sonderswag/Atmel-GPS-Sensor-Watch/TransReciver/RFM69-master/Examples/MotionMote/LasercutCase_R3.dxf

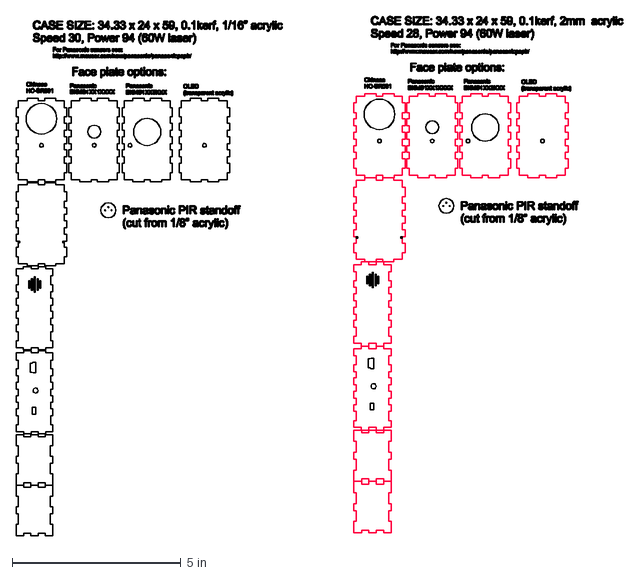
[picture p11: CAD file, 2017-03-10, last stored version]
TransReciver/RFM69-master/Examples/MotionMote/LasercutCase_R3.dxf
18.0 x 15.4 in
