sonderswag/Atmel-GPS-Sensor-Watch/TransReciver/RFM69-master/Examples/SonarMote/SonarMote_lasercut plans_1.75mm acrylic.dxf

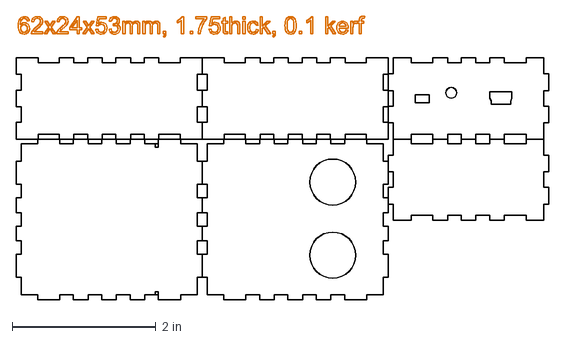
[picture p12: CAD file, 2017-03-10, last stored version]
TransReciver/RFM69-master/Examples/SonarMote/SonarMote_lasercut plans_1.75mm acrylic.dxf
7.41 x 3.94 in
