sonderswag/Atmel-GPS-Sensor-Watch/Digital_IO/DigitalIo.c

//
//  main.c
//  parse_gps
//
//  Created by Christian Wagner on 2/28/17.
//  Copyright © 2017 Christian Wagner. All rights reserved.
//

#include "DigitalIo.h"
// assumes ddr register is already enable for output and not input
void digitalWrite(char port, char state)
{
    pinMode(port, 1); //put to output
    if (port == 1 || (port >= 23 && port <= 28 )) // c
    {
        if (port == 1)
        {
            if (state == 1) PORTC |= (1<<6);

            else PORTC &= ~(1<<6);

        }
        else
        {
            port -= 23;
            if (state == 1) PORTC |= (1<<port);

            else PORTC &= ~(1<<port);

        }
    }
    else if ((port >= 2 && port <= 6) || ( port >= 11 && port <= 13)) // d
    {
        if (port >= 2 && port <= 6)  port -= 2;

        else  port -= 6;

        if (state == 1) PORTD |= (1<<port);

        else PORTD &= ~(1<<port);;

    }
    else if ((port >= 9 && port <= 10) || (port >= 14 && port <= 19)) //b
    {
        if (port >= 9 && port <= 10) port -= 3;

        else port -= 14;


        if (state == 1) PORTB |= (1<<port);

        else PORTB &= ~(1<<port);
    }
}

// changes the pinmode to either input or output
void pinMode(char port, char mode)
{
    if (port == 1 || (port >= 23 && port <= 28 )) // c
    {
        if (port == 1)
        {
            if (mode == 1) DDRC |= (1<<6);

            else DDRC &= ~(1<<6);

        }
        else
        {
            port -= 23;
            if (mode == 1) DDRC |= (1<<port);

            else DDRC &= ~(1<<port);

        }
    }
    else if ((port >= 2 && port <= 6) || ( port >= 11 && port <= 13)) // d
    {
        if (port >= 2 && port <= 6)  port -= 2;

        else  port -= 6;

        if (mode == 1) DDRD |= (1<<port);

        else DDRD &= ~(1<<port);;

    }
    else if ((port >= 9 && port <= 10) || (port >= 14 && port <= 19)) //b
    {
        if (port >= 9 && port <= 10) port -= 3;

        else port -= 14;


        if (mode == 1) DDRB |= (1<<port);

        else DDRB &= ~(1<<port);
    }
}

//reads the digital input to the given pin number
char digitalRead(char port)
{
    pinMode(port, 0); //set to input
        if (port == 1 || (port >= 23 && port <= 28 )) // c
    {
        if (port == 1)
        {
            if ((PINC & 1<<6) == 0)
                return 0;
            else
                return 1;
        }
        else
        {
            port -= 23;
            if ((PINC & 1<<port) == 0x00) return 0;

            else return 1;

        }
    }
    else if ((port >= 2 && port <= 6) || ( port >= 11 && port <= 13)) // d
    {
        if (port >= 2 && port <= 6)  port -= 2;

        else  port -= 6;

        if ( (PIND & 1<<port) == 0x00) return 0;

        else return 1;

    }
    else if ((port >= 9 && port <= 10) || (port >= 14 && port <= 19)) //b
    {
        if (port >= 9 && port <= 10) port -= 3;

        else port -= 14;


        if ((PINB & 1<<port) == 0x00) return 0;

        else return 1;
    }
    return 2; // if something went wrong
}
