sonderswag/Atmel-GPS-Sensor-Watch/(commit log)

2017-03-09 Arduino base files
2017-03-10 working on radio code
    [LasercutCase_R3.dxf, SonarMote_lasercut plans_1.75mm acrylic.dxf, project.cfg]
2017-03-31 test interrupts
2017-04-05 I2C and clean up radio
2017-04-07 bug with ready, attempting to fix
    [RFM69.c, RFM69.h, main.c]
2017-04-11 Have a working version of the radio code.
    [LasercutCase_R3.dxf, SonarMote_lasercut plans_1.75mm acrylic.dxf, project.cfg]
2017-04-17 just menu code
    [project.cfg]
2017-04-17 radio not working in menu
    Radio is not working in menu, or in radio_gps. Radio does work in
    transceiver. Might be a hardware issue
    [GPS.c, GPS.h, LSM.c, RFM69.c, main.c]
2017-04-19 small changes, added temperature to the menu
2017-04-21 fixed steps bug
    took out calibrate in HR and didn’t initialize 0s into volatile struct
    [Heart_rate.c, Heart_rate.h, main.c]
2017-04-21 Finished distance and bearing
2017-04-28 buzzer and distance traveled
    [Screen.c, main.c]
2017-12-01 Cleaning things up
    [LasercutCase_R3.dxf, SonarMote_lasercut plans_1.75mm acrylic.dxf, project.cfg]
